amosborne/modbus-rs485-demo/(list of files, drawings)

Other design files:
altium/modbus_rs485_demo.PrjPcb
altium/pcb.PcbDoc
altium/sch/rs485_interface.SchDoc
altium/sch/schematic.SchDoc
