amosborne/modbus-rs485-demo/(commit log)

2022-05-28 create altium project
    [modbus_rs485_demo.PrjPcb, schematic.SchDoc]
2022-05-29 sch development
    [modbus_rs485_demo.PrjPcb, schematic.SchDoc]
2022-06-05 sch first draft
    [modbus_rs485_demo.PrjPcb, rs485_interface.SchDoc, schematic.SchDoc]
2022-06-06 draft pcb footprints
    [modbus_rs485_demo.PrjPcb, rs485_interface.SchDoc, schematic.SchDoc]
2022-06-07 pcb layout wip
    [modbus_rs485_demo.PrjPcb, pcb.PcbDoc, schematic.SchDoc]
2022-06-10 change to 4-layer pcb
    [modbus_rs485_demo.PrjPcb, pcb.PcbDoc, rs485_interface.SchDoc, schematic.SchDoc]
2022-06-11 finish layout
    [pcb.PcbDoc, schematic.SchDoc]
2022-06-11 complete pcb layout
    [pcb.PcbDoc]
2022-06-12 generate fab files
    [pcb.GBL, pcb.GBO, pcb.GBP, pcb.GBS, pcb.GTL, pcb.GTO, pcb.GTP, pcb.GTS]
2022-07-02 led balancing calc
